matthewnevels/Phase2HBridge2/Phase2HBridge2_BOM.xlsx

Quantity | Reference | Populate | Description | MFG | MFGPN | CR1 | CR1PN | Datasheet | Capacitance | Voltage | Temp | Tolerance | Created | Verified | Temp Coefficient | Value.Display | Current | Resistance | Wattage
1 | Q5 |  | MOSFET N-CH 50V 220MA SOT-23 | Fairchild Semiconductor | BSS138 | DigiKey | BSS138CT-ND | https://www.fairchildsemi.com/datasheets/BS/BSS138.pdf |  | 50V |  |  |  |  |  |  | 220mA
3 | C1-3 |  | CAP ALUM 220UF 200V 20% RADIAL | Panasonic Electronic Components | EEU-ED2D221 | DigiKey | P13522-ND | http://industrial.panasonic.com/www-data/pdf/ABA0000/ABA0000CE123.pdf | 220ÂµF | 200V | -25Â°C:105Â°C | 20% | 2015-02-07 | XXXX-XX-XX
2 | C5,C8 |  | CAP CER 0.1UF 50V 10% X7R 0805 | Kemet | C0805C104K5RACAUTO | DigiKey | 399-6928-1-ND | http://www.kemet.com/docfinder?Partnumber=C0805C104K5RACAUTO | 0.1ÂµF | 50V | -55Â°C:125Â°C | 10% | 2015-02-09 | XXXX-XX-XX | X7R
2 | C6,C7 |  | CAP CER 0.68UF 250V 10% X7R 2220 | Kemet | C2220C684KARACTU | DigiKey | 399-4689-1-ND | http://www.kemet.com/Lists/ProductCatalog/Attachments/53/KEM_C1002_X7R_SMD.pdf | 0.68ÂµF | 250V | -55Â°C:125Â°C | 10% | 2015-02-09 | XXXX-XX-XX | X7R
1 | C4 |  | CAP CER 470PF 630V 5% NP0 1206 | Kemet | C1206C471JBGACTU | DigiKey | 399-5545-1-ND | http://www.kemet.com/Lists/ProductCatalog/Attachments/24/KEM_C1009_C0G_HV_SMD.pdf | 470pF | 630V | -55Â°C:125Â°C | 5% | 2015-02-07 | XXXX-XX-XX | C0G
1 | J1 |  | TERM BLOCK 8POS SIDE ENT 3.5MM | TE Connectivity | 1776275-8 | DigiKey | A98041-ND | http://www.te.com/commerce/DocumentDelivery/DDEController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 |  |  | -55Â°C:105Â°C |  | 2015-02-11 | XXXX-XX-XX |  | CON-8P
4 | J2-5 |  | CONN-FASTON-0.250" | TE Connectivity | 1217861-1 | DigiKey | A100452CT-ND | http://www.te.com/commerce/DocumentDelivery/DDEController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 |  |  |  |  | 2015-02-09 | XXXX-XX-XX
2 | D9,D10 |  | DIODE SCHOTTKY 200V 3A SMB | ON Semiconductor | MBRS3200T3G | DigiKey | MBRS3200T3GOSCT-ND | http://www.onsemi.com/pub_link/Collateral/MBRS3200T3-D.PDF |  | 200V | -65Â°C:175Â°C |  | 2015-02-09 | XXXX-XX-XX |  | MBRS3200T3G | 3A
4 | D1-4 |  | DIODE SCHOTTKY 250V 40A TO220-2 | ON Semiconductor | MBR40250G | DigiKey | MBR40250GOS-ND | http://www.onsemi.com/pub_link/Collateral/MBR40250-D.PDF |  | 250V |  |  | 2015-02-07 | XXXX-XX-XX |  | MBR40250 | 40A
5 | D5-8,D11 |  | DIODE SCHOTTKY 40V 750MA SOT23-3 | Diodes Incorporated | BAT750TA | DigiKey | BAT750CT-ND | http://www.diodes.com/datasheets/BAT750.pdf |  | 40V | 125Â°C |  | 2015-02-07 | XXXX-XX-XX |  | BAT750 | 750mA
4 | Q1-Q4 |  | MOSFET_N-CH_400V_26A_TO-220 | Fairchild Semiconductor | FDP26N40 | DigiKey | FDP26N40-ND | https://www.fairchildsemi.com/datasheets/FD/FDP26N40.pdf |  | 400V | -55Â°C:150Â°C |  | 2015-02-07 | XXXX-XX-XX |  | FDP26N40 | 26A
2 | U1-2 |  | IC GATE DVR HALF BRIDGE 14SOIC | Fairchild Semiconductor | FAN7393AMX | DigiKey | FAN7393AMXCT-ND | https://www.fairchildsemi.com/datasheets/FA/FAN7393A.pdf |  |  | -40Â°C : 125Â°C |  | 2015-02-07 | XXXX-XX-XX |  | FAN7393A
1 | R7 |  | RES SMD 0.0 OHM JUMPER 1/8W 0805 | Panasonic Electronic Components | ERJ-6GEY0R00V | DigiKey | P0.0ACT-ND | http://industrial.panasonic.com/www-cgi/jvcr13pz.cgi?E+PZ+3+AOA0001+ERJ6GEY0R00V+7+WW |  |  | -55Â°C:155Â°C |  |  |  |  |  |  | 0Î© | 0.125W
2 | R8-9 | NO-POP | RES SMD 0.0 OHM JUMPER 1/8W 0805 | Panasonic Electronic Components | ERJ-6GEY0R00V | DigiKey | P0.0ACT-ND | http://industrial.panasonic.com/www-cgi/jvcr13pz.cgi?E+PZ+3+AOA0001+ERJ6GEY0R00V+7+WW |  |  | -55Â°C:155Â°C |  |  |  |  |  |  | 0Î© | 0.125W
3 | R5-6,R10 |  | RES SMD 10K OHM 1% 1/8W 0805 | Panasonic Electronic Components | ERJ-6ENF1002V | DigiKey | P10.0KCCT-ND | http://industrial.panasonic.com/www-cgi/jvcr13pz.cgi?E+PZ+3+AOA0002+ERJ6ENF1002V+7+WW |  |  | -55Â°C:155Â°C |  |  |  |  |  |  | 10kÎ© | 0.125W
4 | R1-4 |  | RES SMD 4.7 OHM 1% 1/4W 1206 | Vishay Dale | CRCW12064R70FKEA | DigiKey | 541-4.70FFCT-ND | http://www.vishay.com/docs/20035/dcrcwe3.pdf |  |  | -55Â°C:155Â°C |  |  |  |  |  |  | 4.7Î© | 0.25W
4 |  |  | HEX STANDOFF 6-32 BRASS 1/2" | Keystone Electronics | 1952 | DigiKey | 1952K-ND | http://www.keyelco.com/product-pdf.cfm?p=5046
4 |  |  | HEX STANDOFF 6-32 BRASS 1-1/2" | Keystone Electronics | 1645 | DigiKey | 1645K-ND | http://www.keyelco.com/product-pdf.cfm?p=5088
1 |  |  | FAN AXIAL 80X25MM 12VDC WIRE | Sunon Fans | EE80251S2-000U-999 | DigiKey | 259-1462-ND | http://media.digikey.com/pdf/Data%20Sheets/Sunon%20PDFs/80x80x25mm.pdf |  | 12V
4 |  |  | CONN QC RCPT 10-12AWG 0.250 | TE Connectivity | 4-520447-2 | DigiKey | A27831CT-ND | http://www.te.com/commerce/DocumentDelivery/DDEController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
10 |  |  | THERMO PAD 5590H TO-220 | 3M | 5590H-TO220 | DigiKey | 3M12137-ND | http://media.digikey.com/pdf/Data%20Sheets/3M%20PDFs/5590H-TO220_Dwg.pdf
10 |  |  | WASHER SHOULDER #4 NYLON | Keystone Electronics | 3049 | DigiKey | 3049K-ND | http://www.keyelco.com/product-pdf.cfm?p=1995
10 |  |  | MACHINE SCREW PAN PHILLIPS 4-40 | Keystone Electronics | 9900 | DigiKey | KEY1046-ND | http://www.keyelco.com/product-pdf.cfm?p=286
