matthewnevels/Phase2HBridge2/Costing.xls

Digi-Key Part Number | Manufacturer | Manufacturer Part Number | Description | Quantity 1 | Price
BSS138CT-ND | FAIRCHILD SEMICONDUCTOR (VA) | BSS138 | MOSFET N-CH 50V 220MA SOT-23 | 25 | 0.14080 | $3.52
P13522-ND | PANASONIC ELECTRONIC COMPONENTS | EEU-ED2D221 | CAP ALUM 220UF 200V 20% RADIAL | 6 | 3.17000 | $19.02
399-6928-1-ND | KEMET (VA) | C0805C104K5RACAUTO | CAP CER 0.1UF 50V 10% X7R 0805 | 100 | 0.04280 | $4.28
399-4689-1-ND | KEMET (VA) | C2220C684KARACTU | CAP CER 0.68UF 250V 10% X7R 2220 | 4 | 2.25000 | $9.00
399-5545-1-ND | KEMET (VA) | C1206C471JBGACTU | CAP CER 470PF 630V 5% NP0 1206 | 2 | 0.92000 | $1.84
A98041-ND | TE CONNECTIVITY AMP | 1776275-8 | TERM BLOCK 8POS SIDE ENT 3.5MM | 2 | 2.57000 | $5.14
A100452CT-ND | TE CONNECTIVITY AMP (VA) | 1217861-1 | CONN QC TAB 0.250 SOLDER | 10 | 0.09900 | $0.99
MBRS3200T3GOSCT-ND | ON SEMICONDUCTOR (VA) | MBRS3200T3G | DIODE SCHOTTKY 200V 3A SMB | 12 | 0.64000 | $7.68
BAT750CT-ND | DIODES INCORPORATED (VA) | BAT750TA | DIODE SCHOTTKY 40V 750MA SOT23-3 | 10 | 0.31700 | $3.17
FAN7393AMXCT-ND | FAIRCHILD SEMICONDUCTOR (VA) | FAN7393AMX | IC GATE DVR HALF BRIDGE 14SOIC | 4 | 2.32000 | $9.28
P0.0ACT-ND | PANASONIC ELECTRONIC COMPONENTS (VA) | ERJ-6GEY0R00V | RES SMD 0.0 OHM JUMPER 1/8W 0805 | 100 | 0.01490 | $1.49
P10.0KCCT-ND | PANASONIC ELECTRONIC COMPONENTS (VA) | ERJ-6ENF1002V | RES SMD 10K OHM 1% 1/8W 0805 | 100 | 0.02190 | $2.19
541-4.70FFCT-ND | VISHAY DALE (VA) | CRCW12064R70FKEA | RES SMD 4.7 OHM 1% 1/4W 1206 | 10 | 0.10200 | $1.02
1952K-ND | KEYSTONE ELECTRONICS | 1952 | HEX STANDOFF 6-32 BRASS 1/2" | 8 | 0.81000 | $6.48
1645K-ND | KEYSTONE ELECTRONICS | 1645 | HEX STANDOFF 6-32 BRASS 1-1/2" | 8 | 1.77000 | $14.16
259-1462-ND | SUNON FANS | EE80251S2-000U-999 | FAN AXIAL 80X25MM 12VDC WIRE | 2 | 2.55000 | $5.10
A27831CT-ND | TE CONNECTIVITY AMP (VA) | 4-520447-2 | CONN QC RCPT 10-12AWG 0.250 | 4 | 0.39000 | $1.56
3M12137-ND | 3M (TC) | 5590H-TO220 | THERMO PAD 5590H TO-220 | 20 | 0.56600 | $11.32
3049K-ND | KEYSTONE ELECTRONICS | 3049 | WASHER SHOULDER #4 NYLON | 20 | 0.12700 | $2.54
KEY1046-ND | KEYSTONE ELECTRONICS | 9900 | MACHINE SCREW PAN PHILLIPS 4-40 | 20 | 0.07500 | $1.50
 |  |  |  |  | Total Component cost for 2 assembled boards | $111.28
 |  |  |  |  | Circuit Solder Stencil | $25.00
 |  |  |  |  | Stencil Frame | $4.99
 |  |  |  |  | Solder Paste | $8.99
 |  |  |  |  | 10 Circuitboards | $40.00
 |  |  |  |  | Grand Total | $190.26
