matthewnevels/Phase2HBridge2/(list of files, cad)

Other CAD files:
HeatSink.skp
