matthewnevels/Phase2HBridge2/HeatSink Dimensions.pdf

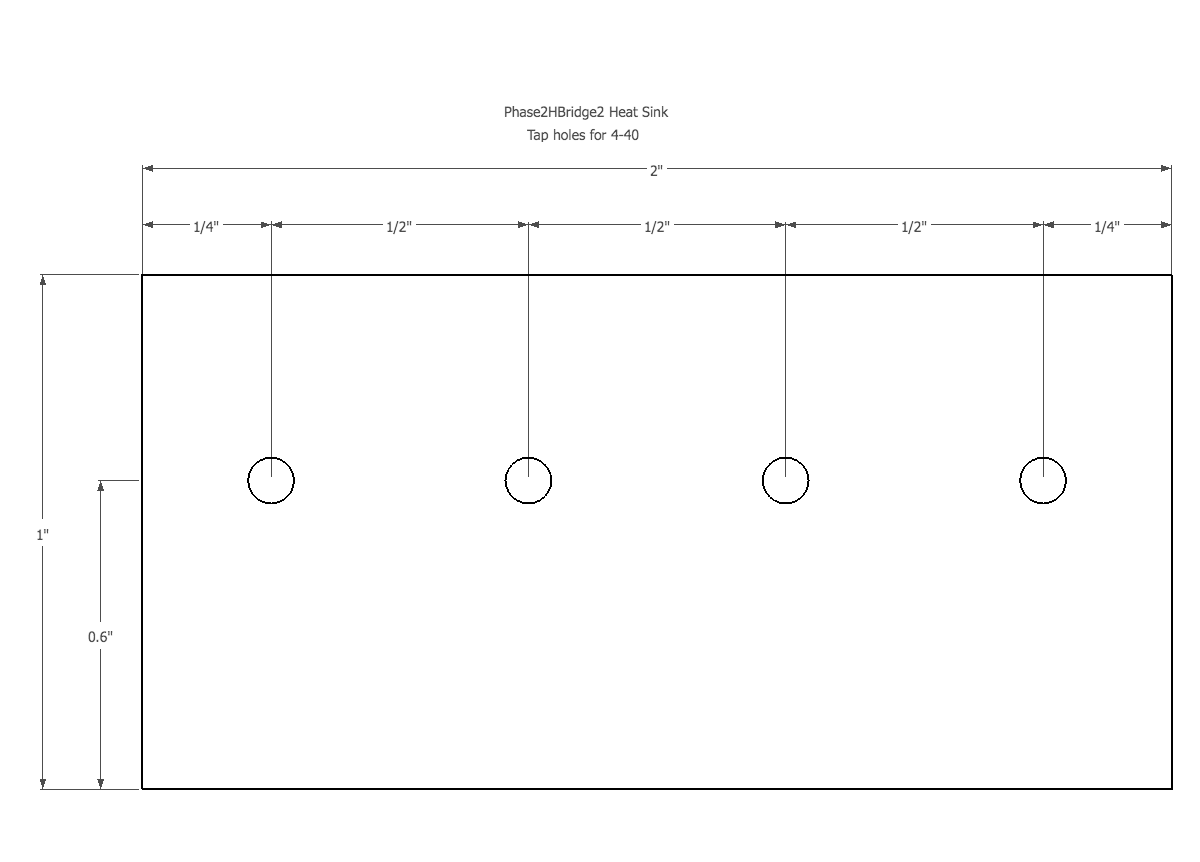
[picture p1: page 1]
