matthewnevels/Phase2HBridge2/Phase2HBridge2_2014-02-09.pdf

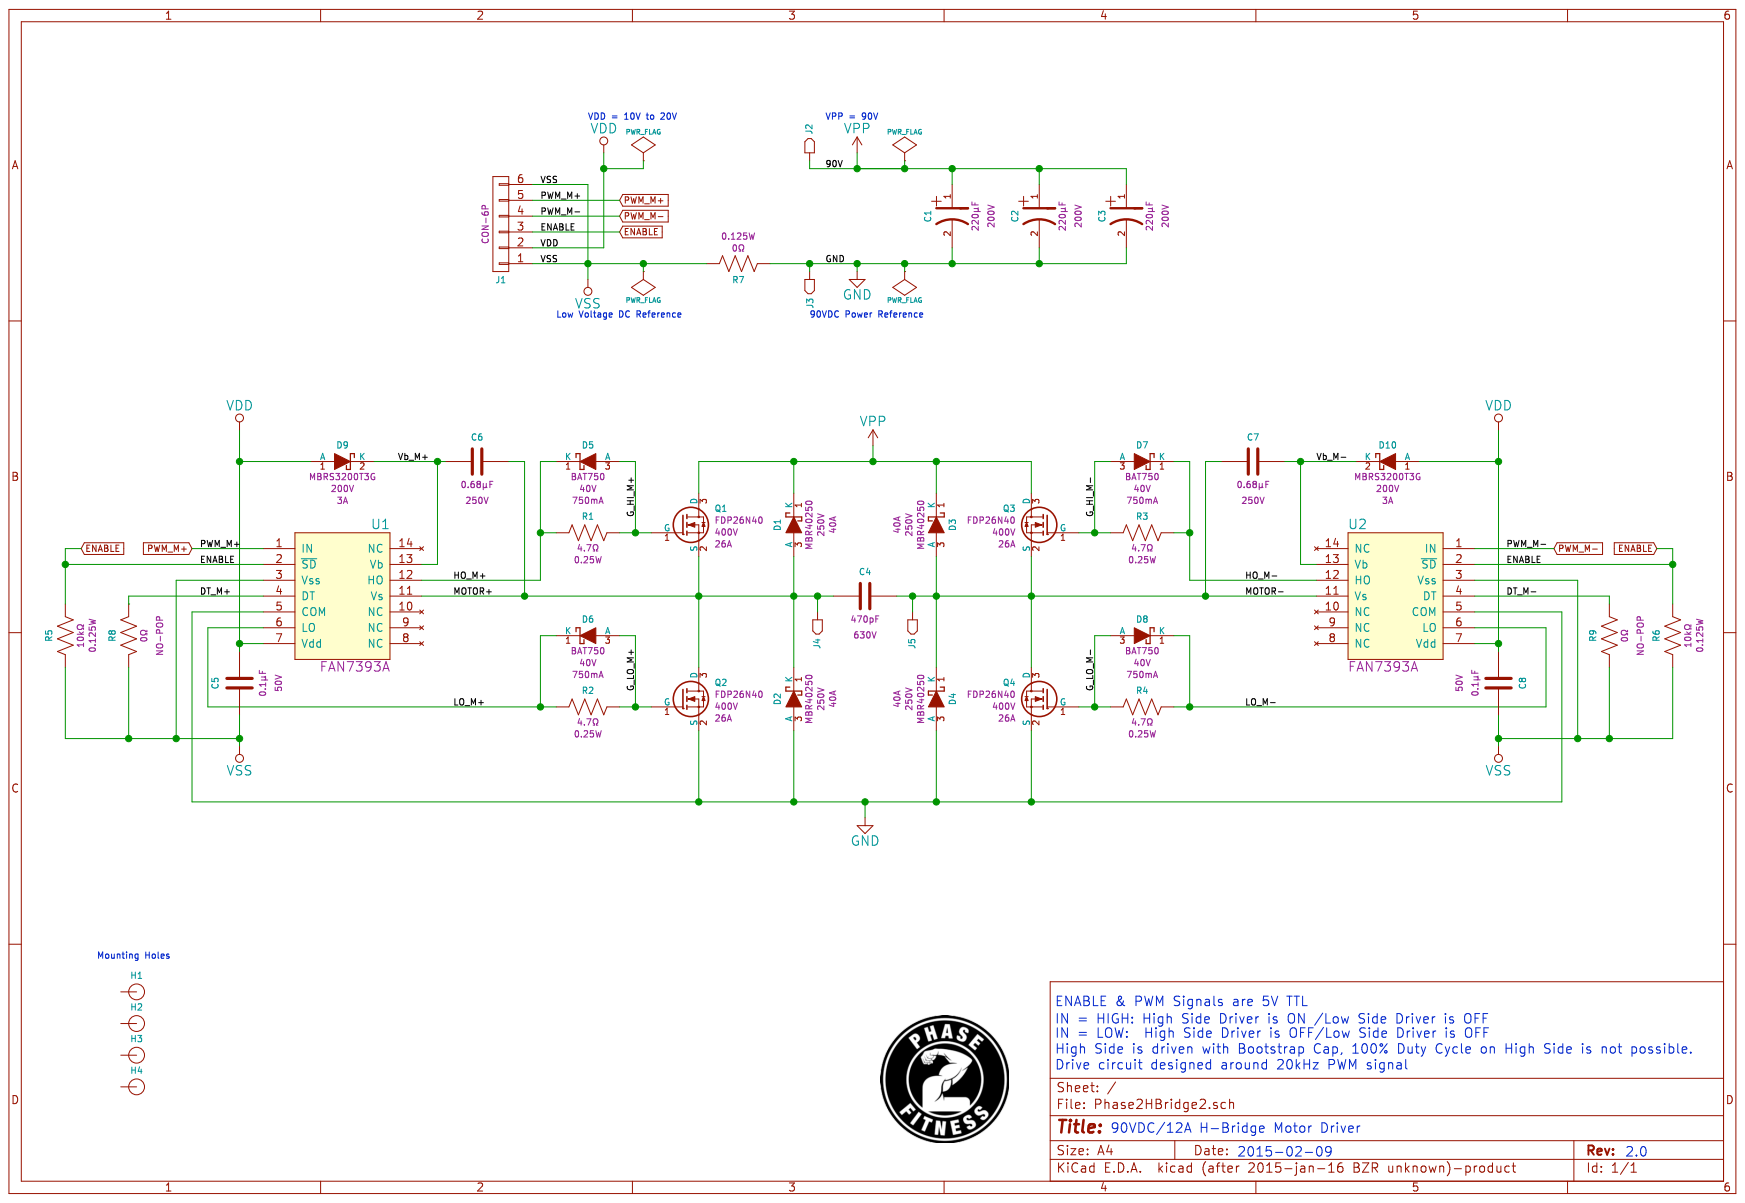
[picture p2: page 1]
