matthewnevels/Phase2HBridge2/Phase2HBridge2.kicad_pcb

## KiCad design Phase2HBridge2.kicad_pcb (2015-03-11)

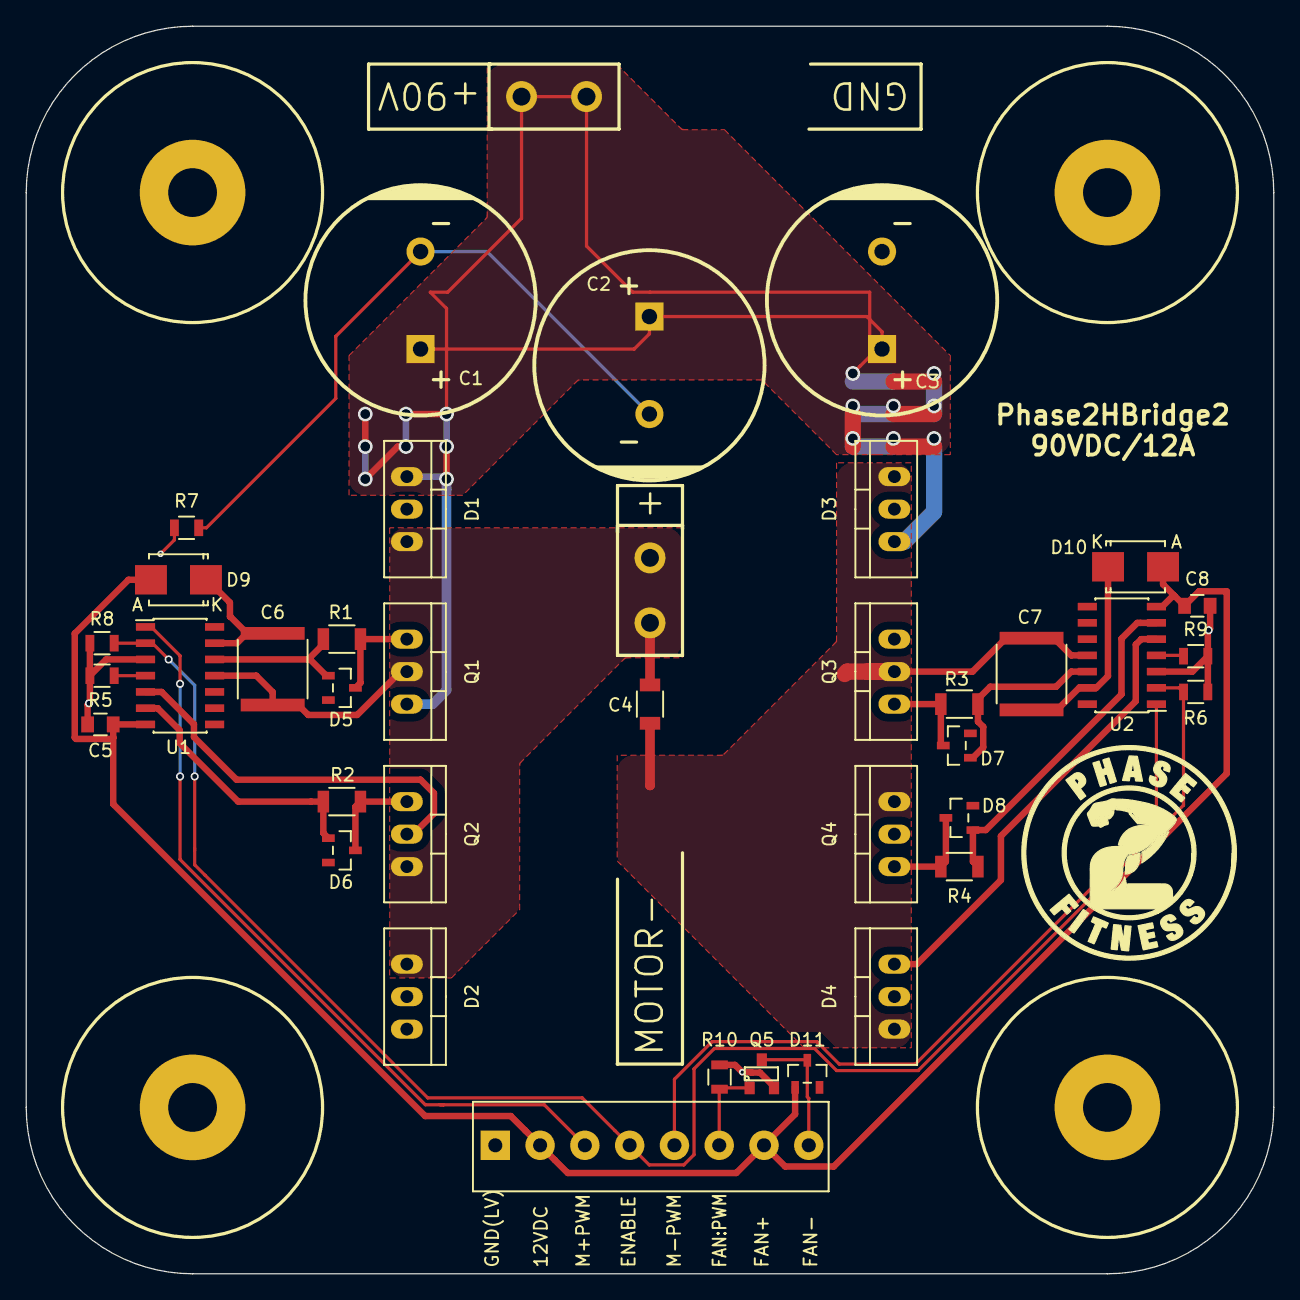
[picture p3: board Phase2HBridge2.kicad_pcb from above]

Board: 2 copper layers, 97.5 x 97.5 mm, 43 parts (0 on the bottom side), 23 nets.

Parts:
C1, C2, C3: CAP-ALUM-220uF-200V-20%-EEU-ED2D221; Capacitor18x31.5RM7.5
C4: CAP-CER-470pF-630V-5%-NPO-1206-C1206C471JBGACTU; C_1206
C5, C8: CAP-CER-0.1uF-50V-10%-X7R-0805-C0805C104K5RACAUTO; C_0805
C6, C7: CAP-CER-0.68uF-250V-10%-X7R-2220-C2220C684KARACTU; C_2220
D1, D2, D3, D4: DIODE-SCH-250V-40A-MBR40250; TO-220_Neutral123_Vertical
D5, D6, D7, D8, D11: DIODE-SCH-40V-750mA-BAT750; sot23
D9, D10: DIODE-SCH-200V-3A-MBRS3200T3G; Diode-SMB_Standard
H1, H2, H3, H4: MountingHole-#6-Conductive
J1: CONN-01X08-TerminalBlock-3.5mm-Side-1776275-8; CON-TerminalBlock-8Pos-Side-3.5MM-1776275-8
J2, J4: CONN-FASTON-0.250; CON-FASTON-0.250-1217861-1
Q1, Q2, Q3, Q4: FET-NCH-400V-26A-TO220-FDP26N40; TO-220_Neutral123_Vertical
Q5: BSS138; SOT-23
R1, R2, R3, R4: RES-4.7-.25W-1%-1206-CRCW12064R70FKEA; R_1206
R5, R6, R10: RES-10k-.125W-1%-0805-ERJ-6ENF1002V; R_0805
R7, R8, R9: RES-0.0-.125W-0805-ERJ-6GEY0R00V; R_0805
U1, U2: IC-Driver-HalfBridge-FAN7393AMX; SOIC-14_3.9x8.7mm_Pitch1.27mm

Connections:
/DT_M+: R8.2, U1.4
/DT_M-: R9.1, U2.4
/G_HI_M+: D5.3, Q1.1, R1.1
/G_HI_M-: D7.3, Q3.1, R3.2
/G_LO_M+: D6.3, Q2.1, R2.1
/G_LO_M-: D8.3, Q4.1, R4.2
/HO_M+: D5.1, R1.2, U1.12
/HO_M-: D7.1, R3.1, U2.12
/LO_M+: D6.1, R2.2, U1.6
/LO_M-: D8.1, R4.1, U2.6
/MOTOR+: C4.2, C6.1, D1.3, D2.1, Q1.2, Q2.3, U1.11
/MOTOR-: C4.1, C7.2, D3.3, D4.1, J4.1, Q3.2, Q4.3, U2.11
/Vb_M+: C6.2, D9.2, U1.13
/Vb_M-: C7.1, D10.2, U2.13
ENABLE: J1.4, R5.1, R6.1, U1.2, U2.2
FAN-: D11.3, J1.8, Q5.3
GND: C1.2, C2.2, C3.2, D2.3, D4.3, J2.1, Q2.2, Q4.2, R7.2, U1.5, U2.5
PWM_FAN: J1.6, Q5.1, R10.1
PWM_M+: J1.3, U1.1
PWM_M-: J1.5, U2.1
VDD: C5.2, C8.1, D9.1, D10.1, D11.1, J1.2, J1.7, U1.7, U2.7
VPP: C1.1, C2.1, C3.1, D1.1, D3.1, Q1.3, Q3.3
VSS: C5.1, C8.2, J1.1, Q5.2, R5.2, R6.2, R7.1, R8.1, R9.2, R10.2, U1.3, U2.3
