matthewnevels/Phase2HBridge2/(commit log)

2015-02-09 Initial Commit
    Schematic is ready for review
    [Phase2HBridge2.sch]
2015-02-09 PCB Started
    [Phase2HBridge2.kicad_pcb, Phase2HBridge2.sch]
2015-02-10 Parts Placed - Need to Route
    [Phase2HBridge2.kicad_pcb]
2015-02-12 Finished Layout
    Need to Verify Layout, add graphics, update refused locations, etc…
    [Phase2HBridge2.kicad_pcb, Phase2HBridge2.sch]
2015-03-11 Finished Design
    [Costing.xls, HeatSink.skp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]
2015-03-11 Final Commit
    [Phase2HBridge2.kicad_pcb]
